CallMeC/RP2040_FT8_TRX/README.md

# RP2040_FT8_TRX
Yet another RP2040 project, but this time radio ham

# Features :
- USB Serial communication
- Class-E Amplifier (25W target)
- Accurate clock generator (Si5351)

Capture d'écran 2025-04-05 213534
Capture d'écran 2025-04-05 213553
Capture d'écran 2025-04-05 213559
