CallMeC/RP2040_FT8_TRX/HW/FT8_RP2040_TRX/Project Outputs/Fabrication/BOM/FT8.xlsx

Designator | Comment | Description | Footprint | Quantity | LCSC_Part_# | LCSC_Price_1ku | MFR_Part_# | MFR
BT1 | BAT-HLD-001 | CR2032 Phosphor Bronze / Nickel Plated 20 mm Cell Size Battery Holder | BATHLD-001 | 1 | C7501066 | 0.4659 | BAT-HLD-001 | TE Connectivity
C1, C3, C18, C26, C28, C30, C32, C41 | 10u X5R 35V 10% 0603 | MLCC 10u X5R 35V 10% 0603 | C0603 | 8 | C194427 | 0.0213 | GRM188R6YA106MA73D
C2, C4, C5, C6, C21, C27, C29, C31, C33, C42, C48, C49, C50, C51, C52, C53, C54, C56, C58, C59, C60, C67 | 100 nF 10% 50 V 0603 | Chip Capacitor, 100 nF, +/- 10%, 50 V, 0603 (1608 Metric) | CAPC1608X90X40NL10T20 | 22 | C14663 | 0.0015 | CC0603KRX7R9BB104
C7, C11 | 2.2nF 10% X7R 50V | Chip Capacitor, 2.2nF, 10%, 50 V, 0603 | CAPC1608X90X40NL10T20 | 2 | C107082 | 0.0021 | CC0603KRX7R9BB222
C8, C14, C16 | RVT2A100M0810 | Cap Aluminum 10uF 100V 20% (8 X 10.2mm) SMD 85mA 2000 hr 85°C T/R | FP-SF-MFG | 3 | C2895755 | 0.0415 | RVT2A100M0810 | Honor Elec
C9, C15 | 100 nF 10% 100V | Chip Capacitor, 100 nF, +/- 10%, 100 V, 0603 (1608 Metric) | CAPC1608X90X40NL10T20 | 2 | C15725 | 0.0066 | CL10B104KC8NNNC | Samsung
C10, C17 | 1uF X7R 10% 100 V 0805 | Chip Capacitor, 1 uF, X7R 10%, 100 V, 0805 | CAPC2013X95X50NL10T25 | 2 | C22367837 | 0.0246 | HHV0805R7105K101NSLJ
C12 | 22u X7R 25V 10% 1210 | MLCC 22u X7R 25V 10% 1210 | C1210 | 1 | C309062 | 0.0679 | CL32B226KAJNNNE
C13 | 68p 10% 50V | Chip Capacitor, 68pF, +/- 10%, 50 V, 0603 (1608 Metric) | CAPC1608X90X40NL10T20 | 1 | C62782 | 0.0019 | CC0603JRNPO9BN680
C19, C24 | FKP2O111001I00HC00 | Condensateurs à film FKP 2 1000 pF 1000 VDC 6.5x8x7.2 PCM 5 | FKP2O111001I00HC00-Footprint-1 | 2 |  |  | FKP2O111001I00HC00
C20 | FKP2D002201D00HA00 | Condensateurs à film 220 pF 100 VDC 2.5% | FKP2O111001I00HC00-Footprint-1 | 1 |  |  | FKP2O111001I00HC00
C22 | FKP2F004701D00HA00 | Condensateurs à film 470 pF 250 VDC 2.5% | FKP2O111001I00HC00-Footprint-1 | 1 |  |  | FKP2F004701D00HA00
C23 | FKP2D012201D00HC00 | Condensateurs à film 2200pF 100 Volt 2.5% | FKP2O111001I00HC00-Footprint-1 | 1 |  |  | FKP2D012201D00HC00
C34 | 470nF 20% 25V 0603 | Chip Capacitor, 470nF +/-20%, 25V, 0603, Thickness 1 mm | CAPC0603(1608)100_L | 1
C35, C37, C47, C55, C57, C62, C66, C69 | 4.7uF 10% 16 V 0603 | Chip Capacitor, 4.7uF, +/- 10%, 16V, 0603 (1608 Metric) | CAPC1608X90X40NL10T20 | 8 | C19666 | 0.0063 | CL10A475KO8NNNC
C36, C68 | 1nF 10% 50 V 0603 | Chip Capacitor, 1 nF, 10%, 50 V, 0603 (1608 Metric) | CAPC1608X90X40NL10T20 | 2 | C1588 | 0.0020 | CL10B102KB8NNNC
C38 | 22n X7R 100V 10% 0603 | MLCC 22n X7R 100V 10% 0603 | C0603 | 1 | C313105 | 0.0071 | CC0603KRX7R0BB223
C39, C40 | 22pF 10% 16V 0603 | Chip Capacitor, 22pF, 10%, 16V, 0603 (1608 Metric) | CAPC1608X90X40NL10T20 | 2 | C561800 | 0.0209 | C0603C220J4GAC7867
C43, C44, C70, C71, C72 | 10 nF 10% 50 V 0603 | Chip Capacitor, 10 nF, +/- 10%, 50 V, 0603 (1608 Metric) | CAPC1608X90X40NL10T20 | 5 | C57112 | 0.0015 | 0603B103K500NT
C45 | 20 pF 5% 16V | Chip Capacitor, 20 pF, +/- 5%, 16V, 0603 (1608 Metric) | CAPC1608X90X40NL10T20 | 1 | C2190570 | 0.0022 | CC0603JRNPO7BN200
C46 | 20 pF +/- 5% 16 V 0603 | Chip Capacitor, 20 pF, +/- 5%, 16V, 0603 (1608 Metric) | CAPC1608X90X40NL10T20 | 1 | C2190570 | 0.0022 | CC0603JRNPO7BN200
C61, C63, C64, C65 | 2.2nF 10% X7R 50V 0603 | Chip Capacitor, 2.2nF, 10%, 50 V, 0603 | CAPC1608X90X40NL10T20 | 4 | C107082 | 0.0021 | CC0603KRX7R9BB222
CN1 | DX07S024JJ3R1300 | USB-C Connector, 20 V, 1.25 A, -30 to 80 degC, RoHS, Tape and Reel | JAE-DX07S024JJ3_V | 1
D1, D2, D3, D4, D5, D7 | KT-0603G | 0603 Green LED | LED-0603-RED | 6 | C12624 | 0.0068 | KT-0603G
D6 | SS210 | Schottky Diode, 2A, 100V, Smb | DO214AC(SMA) | 1 | C14996 | 0.0124 | SS210
J1 | 2.54-1*4P | 2.54mm Single Row 3A 4P Bronze -40℃~+105℃ Direct Insert 1x4P Top Square Hole Plugin,P=2.54mm Female Headers ROHS | FP-87224-3-MFG | 1 | C2718488 | 0.026 | 2.54-1*4P | BOOMELE(Boom Precision Elec)
J3 | MX635-6.35-02P-GN01-Cu-PS-A | Copper Alloy 1x2P Tin 6.35mm 4 1 2 -40℃~+105℃ 30A 300V Green 10~26 Straight Plugin,P=6.35mm Screw terminal ROHS | MX635-6.35-02P-GN01-Cu-PS-A-Footprint-1 | 1 | C5188489 | 0.1045 | MX635-6.35-02P-GN01-Cu-PS-A
J4, J6 | BWSMA-KE-P001 | 1 Inner Hole SMA Board-End Staggered pins 50Ω 5.2mm SMD Coaxial Connectors (RF) ROHS | TE_CONSMA020.062-G | 2 | C496550 |  | BWSMA-KE-P001 | BAT WIRELESS
J5 | SJ1-3523N | 3.5 mm, Stereo, Right Angle, Through Hole, 3 Conductors, 0 Internal Switches, Audio Jack Connector | CUI_SJ1-3523N | 1 | C20182914 | 0.6476 | SJ1-3523N | CUI
K1 | SRD-05VDC-SL-C | 5V Trigger Relay Module For Arduino And Raspberry Pi 5V Trigger Relay Module For Arduino And Raspberry Pi | RELAY_SRD-05VDC-SL-C | 1 | C35449 | 0.18 | SRD-05VDC-SL-C
L1 | SMDRI127-680MT | 2.1A 68uH Shielded inductor ±20% 4A SMD,12.3x12.3mm Power Inductors ROHS | SUMI-CDRH127_V | 1 | C9907 | 0.0993 | SMDRI127-680MT
L2 | FXL0630-100-M | 4.5A 10uH Molding Choke ±20% 5.5A SMD,6.6x7mm Power Inductors ROHS | INDP7066X30N | 1 | C167223 | 0.0934 | FXL0630-100-M
L3 | SRR5228A-100M | Inductances de puissance - CMS Ind,5.2x5.2x2.8,10uH+/-20%,2.3A,shd | INDP5252X32N | 1 |  |  | SRR5228A-100M | Bourns
L4 | LQH55DNR12M03L | Inductor Power Chip Unshielded Wirewound 120nH 20% 1MHz Ferrite 6A 9.8mOhm DCR 2220 T/R | FP-LQH55DN_03-MFG | 1 | C711154 | 0.2902 | LQH55DNR12M03L | Murata
L5 | 7449150146 | Inductor, 146Nh, 332Mhz, 19A, 20% Rohs Compliant: Yes | 7449150146 | 1 |  |  | 7449150146 | Wurth Elektronik
Q1 | CSD19538Q2 | 100-V, N channel NexFET™ power MOSFET, single SON 2 mm x 2 mm, 59 mOhm 6-WSON -55 to 150 | FP-DQK0006C-MFG | 1 | C2838636 | 0.3656 | CSD19538Q2
Q2 | 2N7002K | Mosfet N-ch 60V 300MA SOT23 / Trans Mosfet N-ch 60V 0.3A 3-PIN SOT-23 T/r | FP-318-08-IPC_B | 1 | C5247922 | 0.00119 | 2N7002K
R1, R8, R10, R15, R16, R18, R20 | 1K 1% 0.1W | Standard Resistor 1K 1% 0.1W 0603 | R0603 | 7 | C21190 | 0.0007 | 0603WAF1001T5E
R2 | 10K 1% 0.1W | Standard Resistor 10K 1% 0.1W 0603 | R0603 | 1 | C25804 | 0.0007 | 0603WAF1002T5E
R3, R5 | 681K 1% 0.1W | Standard Resistor 681K 1% 0.1W 0603 | R0603 | 2 | C23229 | 0.0007 | 0603WAF6813T5E
R4 | 0R 1% 0.1W | Standard Resistor 0R 1% 0.1W 0603 | R0603 | 1 | C21189 | 0.0006 | 0603WAF0000T5E
R6 | 100K 1% 0.1W | Standard Resistor 100K 1% 0.1W 0603 | R0603 | 1 | C25803 | 0.0007 | 0603WAF1003T5E
R7 | 215K 1% 0.1W 0603 | Standard Resistor 215K 1% 0.1W 0603 | R0603 | 1 | C5713280 | 0.0007 | FRC0603F2153TS
R9 | 10R 1% 0.1W 0603 | Standard Resistor 10R 1% 0.1W 0603 | R0603 | 1 | C22859 | 0.0007 | 0603WAF100JT5E
R11, R22 | 27R 1% 0.1W 0603 | Standard Resistor 27R 1% 0.1W 0603 | R0603 | 2 | C25224 | 0.0007 | 0603WAJ0270T5E
R12, R13, R23, R26, R29, R30, R31, R32, R33 | 10K 1% 0.1W 0603 | Standard Resistor 10K 1% 0.1W 0603 | R0603 | 9 | C25804 | 0.0007 | 0603WAF1002T5E
R14, R21 | 5.1K 1% 0.1W 0603 | Standard Resistor 5.1K 1% 0.1W 0603 | R0603 | 2 | C23186 | 0.0007 | 0603WAF5101T5E
R17 | 2K 1% 0.1W 0603 | Standard Resistor 2K 1% 0.1W 0603 | R0603 | 1 | C22975 | 0.0007 | 0603WAF2001T5E
R19 | 100R 1% 0.1W 0603 | Standard Resistor 100R 1% 0.1W 0603 | R0603 | 1 | C22775 | 0.0008 | 0603WAF1000T5E
R24, R25 | 0R 1% 1206 250 mW | Chip Resistor, 0 Ohm, 0.25 W, -55 to 155 degC, 1206 (3216 Metric) | RESC3116X70X50ML13T20 | 2
SW1, SW2, SW3, SW4, SW5 | SKRPASE010 | Tactile Switches 500mOhm 2.55N 16VDC 4.2X3.2X2.5MM 50mA | SKRPASE010 | 5 | C470427 | 0.0694 | SKRPASE010
U1, U6, U7 | AP2127K-3.3TRG1 | IC REG LDO 3.3V 0.3A SOT23-5 | FP-SOT25-IPC_B | 3 | C156285 | 0.0388 | AP2127K-3.3TRG1 | Diodes Incorporated
U2 | SI5351A-B-GTR | IC CLK GENERATOR 160MHZ 10MSOP | FP-SI5351A-B-GTR-IPC_B | 1 | C504891 | 0.5946 | SKYWORKS/SILICON LABS | SI5351A-B-GTR
U3 | DS1302Z | Three-Wire Serial Interface SOP-8 Real Time Clocks ROHS | SO8 | 1 | C2900599 | 0.1005 | DS1302Z | JSMSEMI
U4 | LM5164DDAR | 6-V to 100-V input, 1-A synchronous buck DC-DC converter with ultra-low IQ 8-SO PowerPAD -40 to 150 | FP-DDA0008E-IPC_B | 1 | C477928 | 0.3281 | LM5164DDAR
U5 | UCC27519DBVT | 4-A/4-A single-channel gate driver with 5-V UVLO, enable, and CMOS input 5-SOT-23 -40 to 140 | FP-DBV0005A-IPC_B | 1 | C2676969 | 0.5183 | UCC27519DBVT | Texas Instruments
U8 | SI4735-D60-GU | RF Receiver AM/FM/LW/SW 3.3V/5V Automotive 24-Pin SSOP Tube | SLAB-SSOP-24_N | 1 | C1526089 | 8.7411 | SI4735-D60-GU | SKYWORKS/SILICON LABS
U9 | RP2040 | 133MHz LQFN-56(7x7) Microcontrollers (MCU/MPU/SOC) ROHS ARM® Cortex®-M0+ MCU 32-Bit | QFN40P700X700X90-57N | 1 | C2040 | 0.6733 | RP2040 | Raspberry Pi
U10 | W25Q16JVUXIQ | 16Mb Serial NOR Flash 133MHz USON8 | FP-UX-IPC_B | 1 | C2843335 | 0.2127 | W25Q16JVUXIQ | Winbond Elec
U11 | SN74LV4052APWR | 2 Circuit IC Switch 4:1 75 Ohm 16-TSSOP | PW0016A_N | 1 | C8142 | 0.0974 | SN74LV4052APWR | Texas Instruments
U12 | MCP6002-I/SN | MCP6002 Series 6 V 1 MHz SMT Low-Power Operational Amplifier - SOIC-8 | SOIC-SN8_N | 1 | C116706 | 0.238 | MCP6002-I/SN | Microchip Tech
Y1 | XG1EL89CKI-111YLC-25M | 25MHz Surface Mount Crystal 8pF ±10ppm ±20ppm SMD5032 Crystals ROHS | X50328MSB2GI-Footprint-1 | 1 | C19711738 | 0.1118 | XG1EL89CKI-111YLC-25M
Y2, Y3 | Q13FC13500049 | 32.768kHz Surface Mount Crystal 6pF ±20ppm SMD3215-2P Crystals ROHS | FP-ABS07-120-MFG | 2 | C95361 | 0.1269 | Q13FC13500049 | Seiko Epson
Y4 | X503212MSB2GI | 12MHz Surface Mount Crystal 20pF ±10ppm ±20ppm SMD5032 Crystals ROHS | X50328MSB2GI-Footprint-1 | 1 | C112573 | 0.1205 | X503212MSB2GI
