CallMeC/RP2040_FT8_TRX/(threads)

Thread 1 (2024-07-28):

how do i get it?

DuckyPolice, 2024-07-28:
how do i get it. its just readme

CallMeC, 2024-07-28:
Hi !
I did'nt upload any schematics / code yet since I've been working on other project. So far I only made the Class-E amp. I'll upload soon :)
Best regards,

DuckyPolice, 2024-07-28:
does/will it run barebones without anything except for an antenna attached to the pico?

CallMeC, 2024-07-29:
Hi !
As this projects deals with high frequencies, I was planning on using an external oscillator to make the signal, it would be connected to an amplifier.
I am not sure if the RP2040 has the correct ressources to achieve a high frequency (with proper harmonics levels) and high power output.
Any suggestion is welcomed !
Best regards :)
