CallMeC/RP2040_FT8_TRX/HW/FT8_RP2040_TRX/Project Outputs/Fabrication/Schematic Prints/FT8.PDF

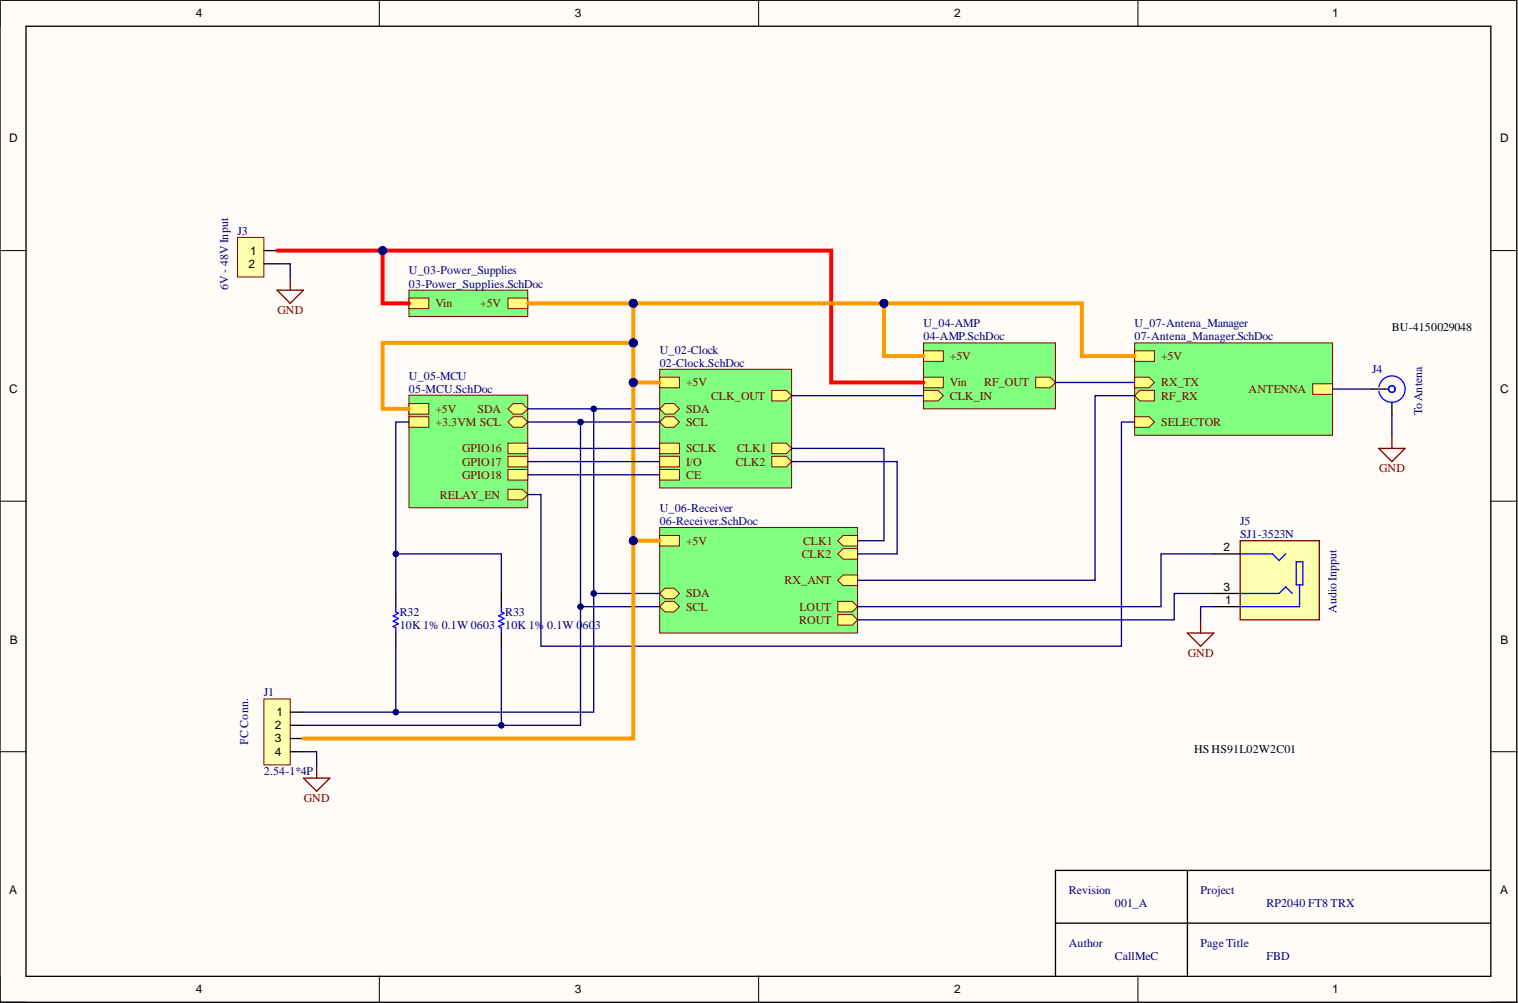
[picture p1: page 1]

i s i o n 0 0 1 _A | Projec t RP2 0 4 0 FT 8 TRX

A u t h o r Cal lMe C | Page T i l e FBD

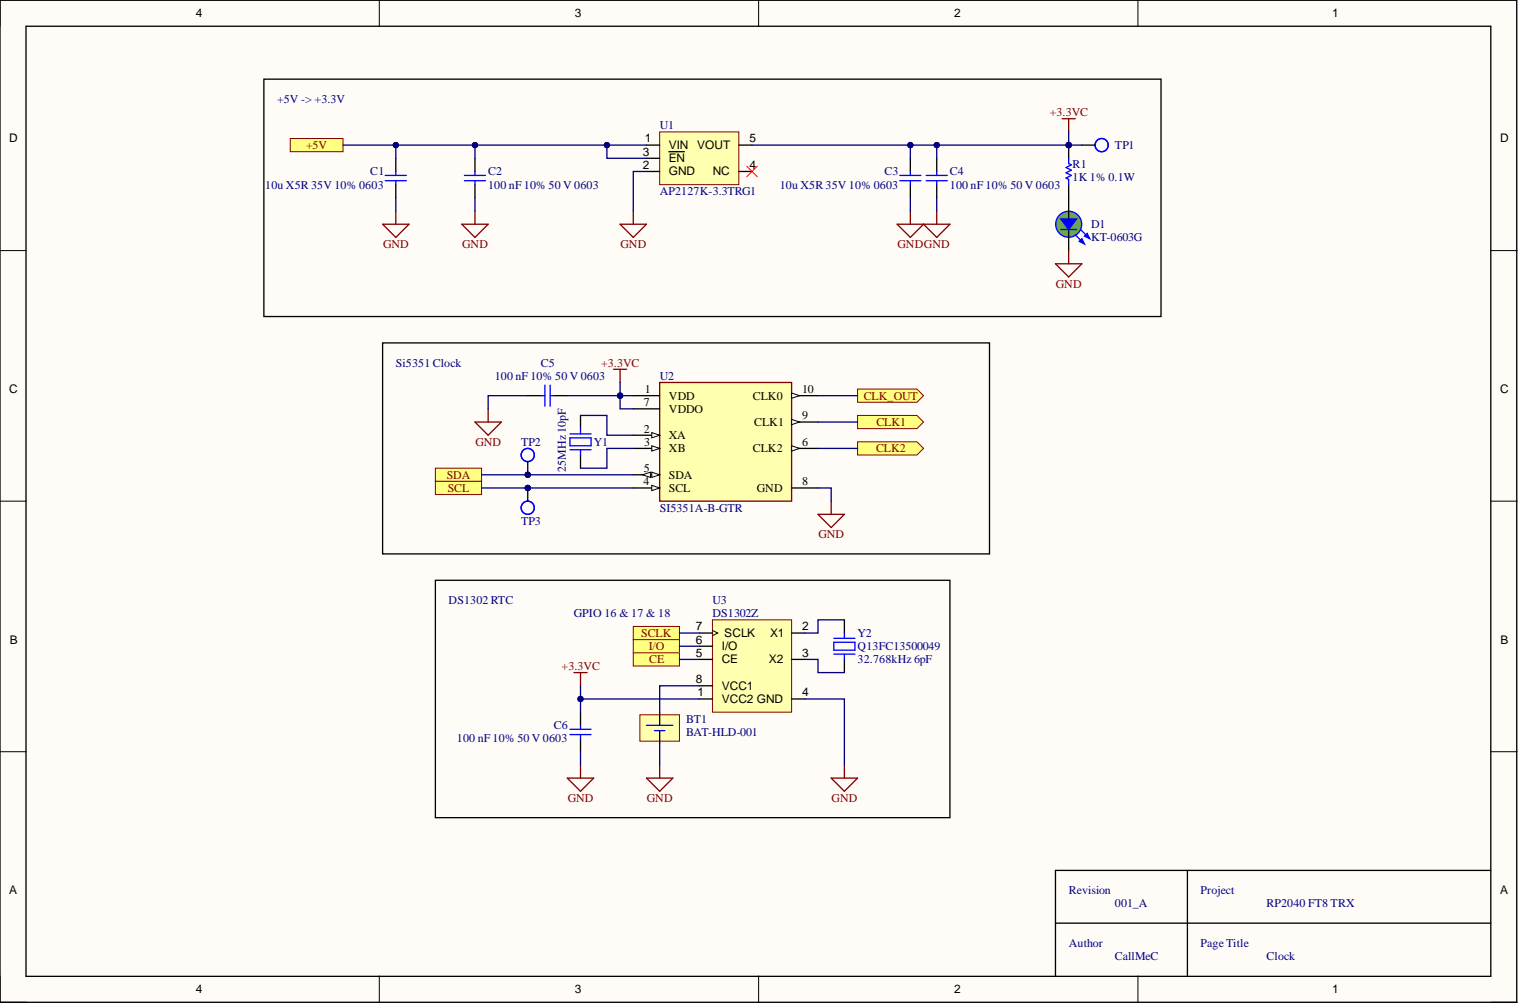
[picture p2: page 2]

001_A | Project RP2040 FT8 TRX

Author CallMeC | Page Title Clock

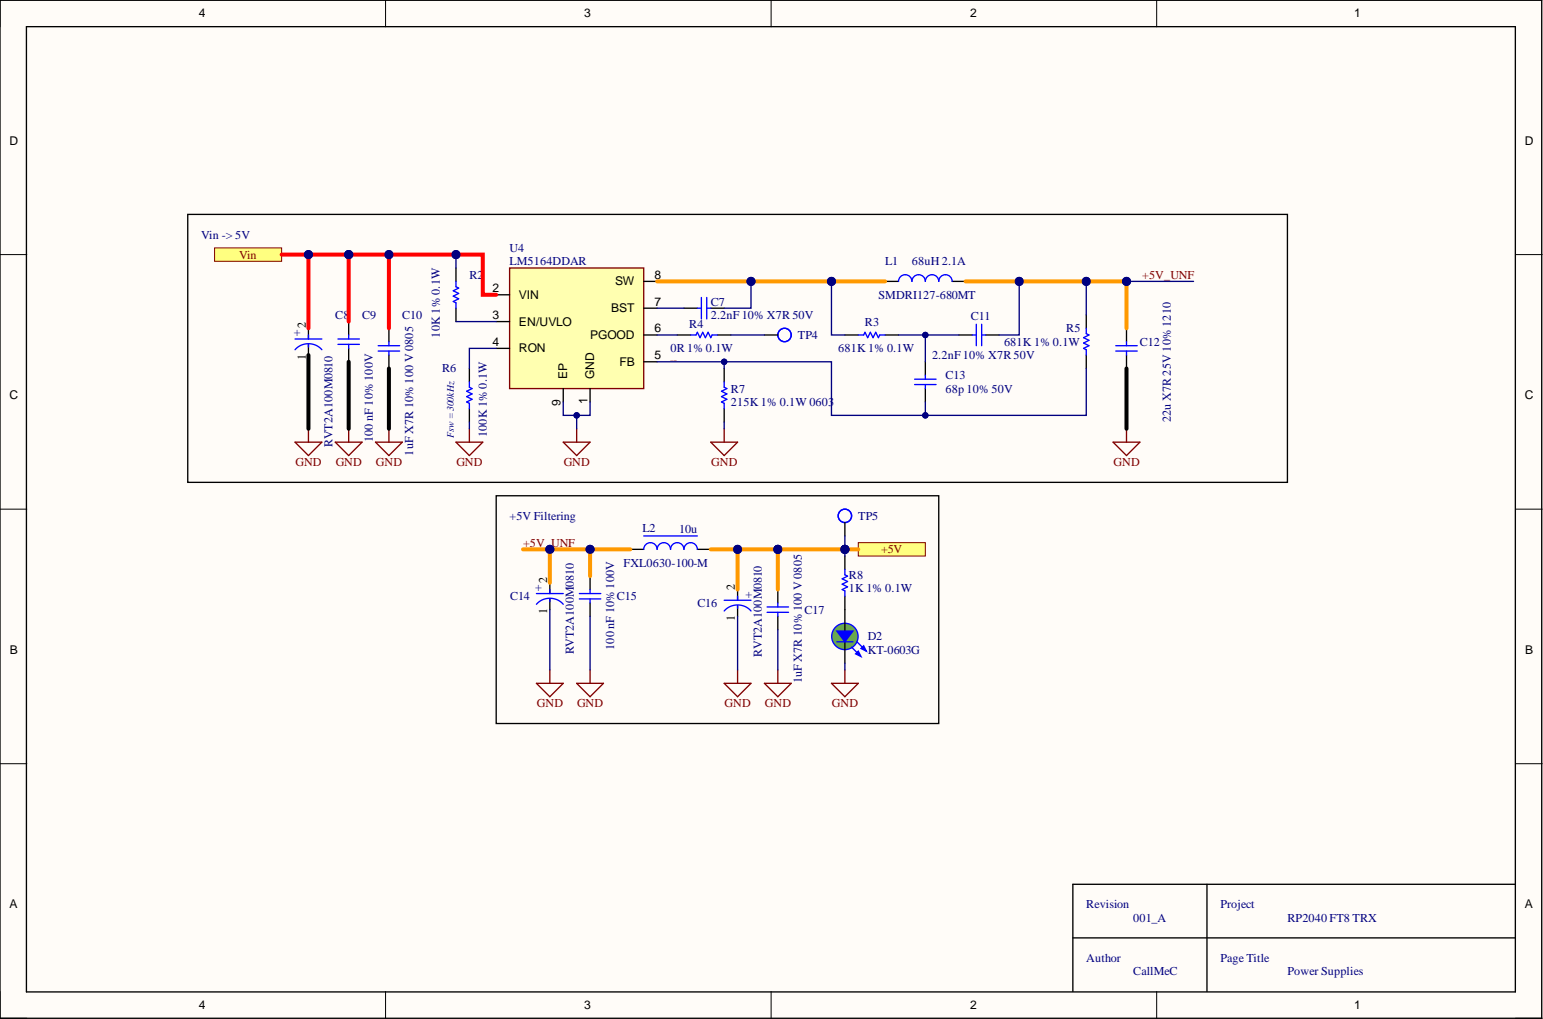
[picture p3: page 3]
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

Po wer Su p p s

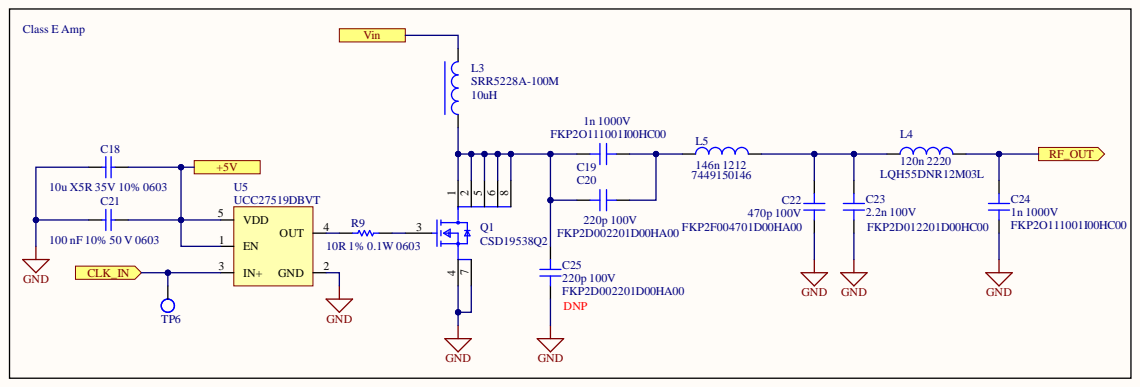
[picture p4: page 4]
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

Amp ifi er

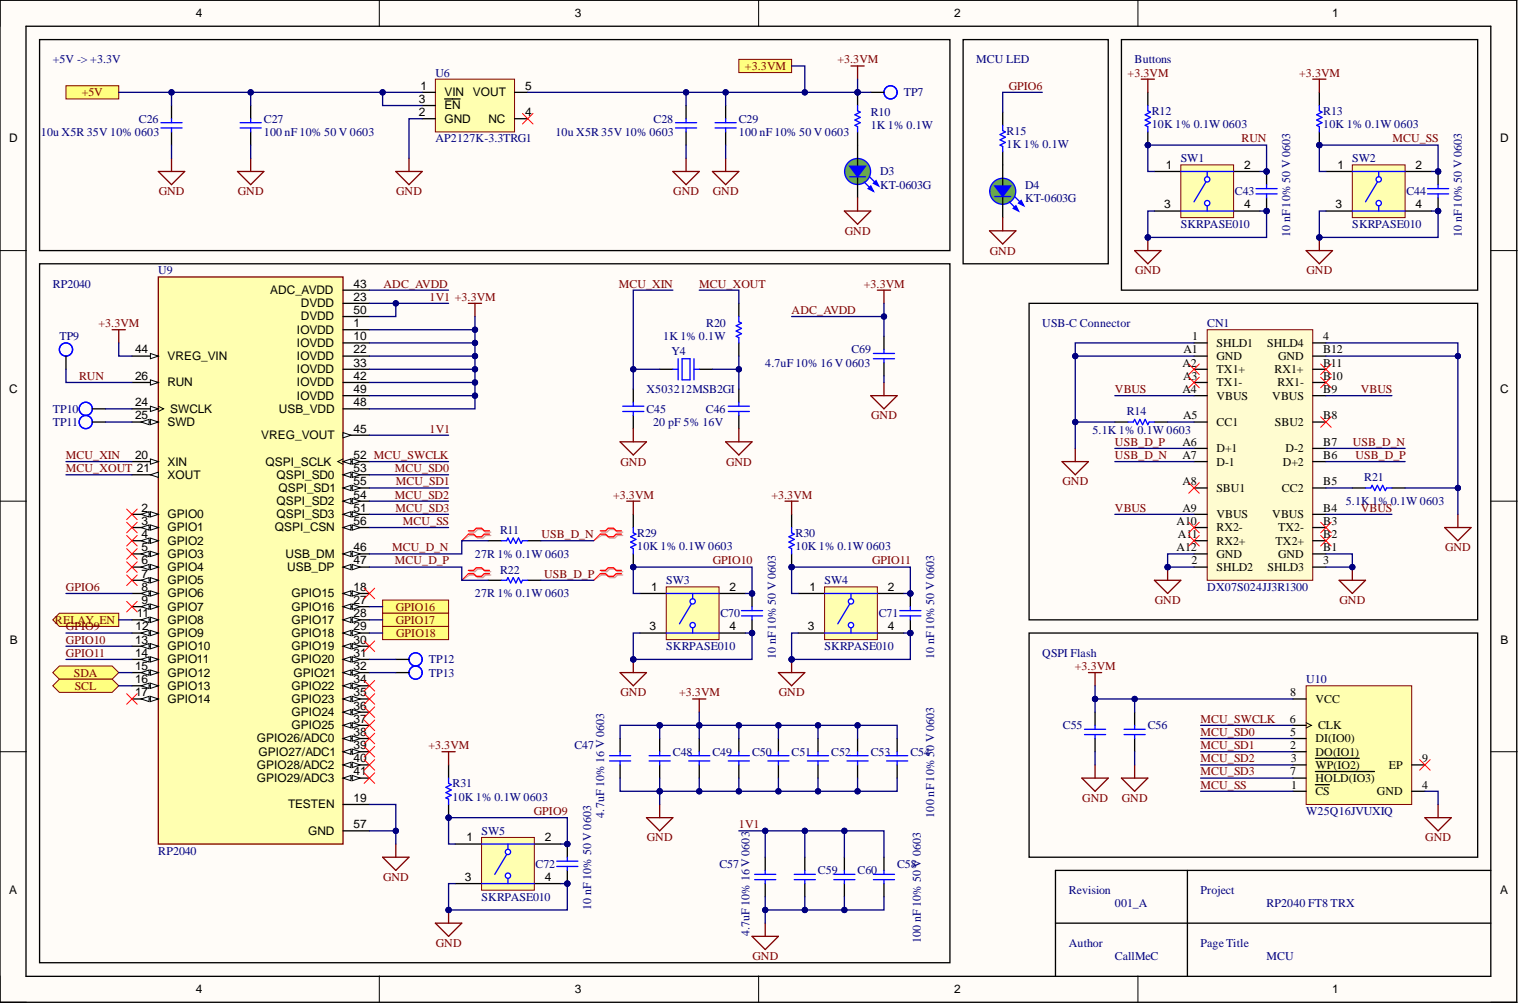
[picture p5: page 5]
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

MCU

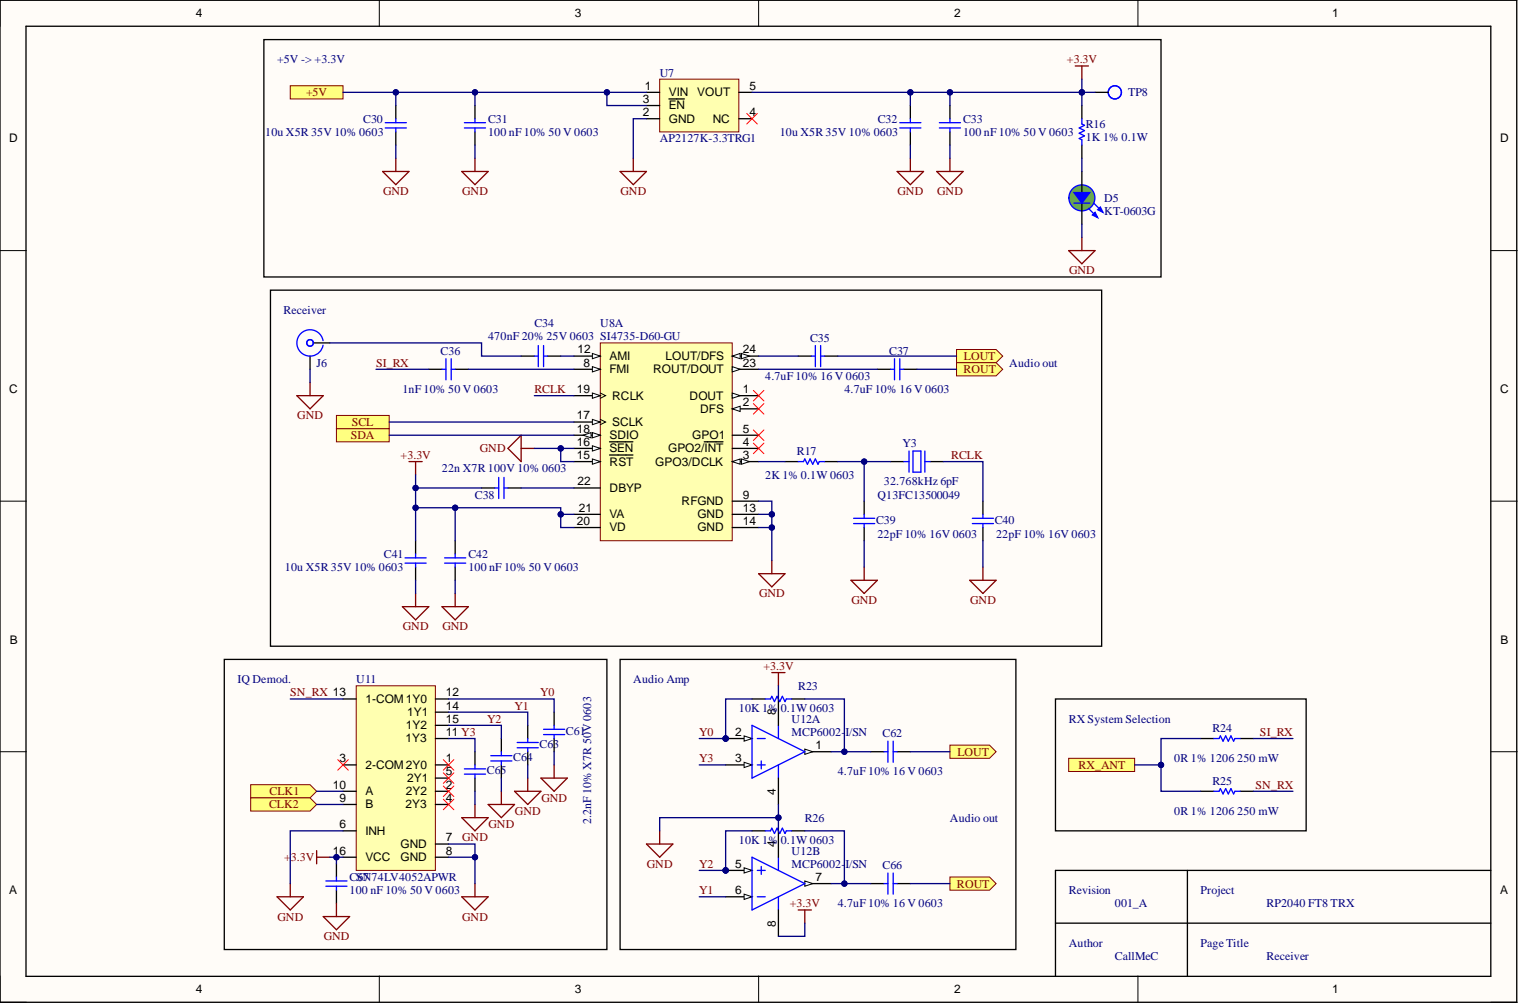
[picture p6: page 6]

VIN 1 | GND
EN 3
GND 2

VCC 16

001_A | Project RP2040 FT8 TRX

Receiver

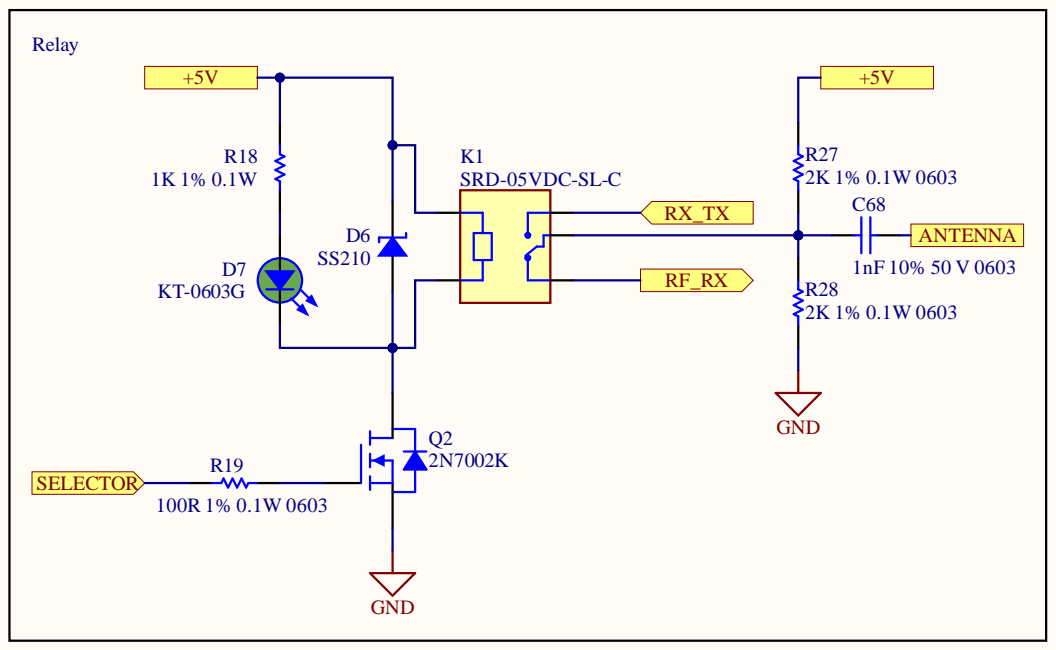
[picture p7: page 7]

001_A | Project RP2040 FT8 TRX

Antena Manager
