CallMeC/RP2040_FT8_TRX/HW/FT8_RP2040_TRX/Project Outputs/Fabrication/Fabrication Drawing/FT8.PDF

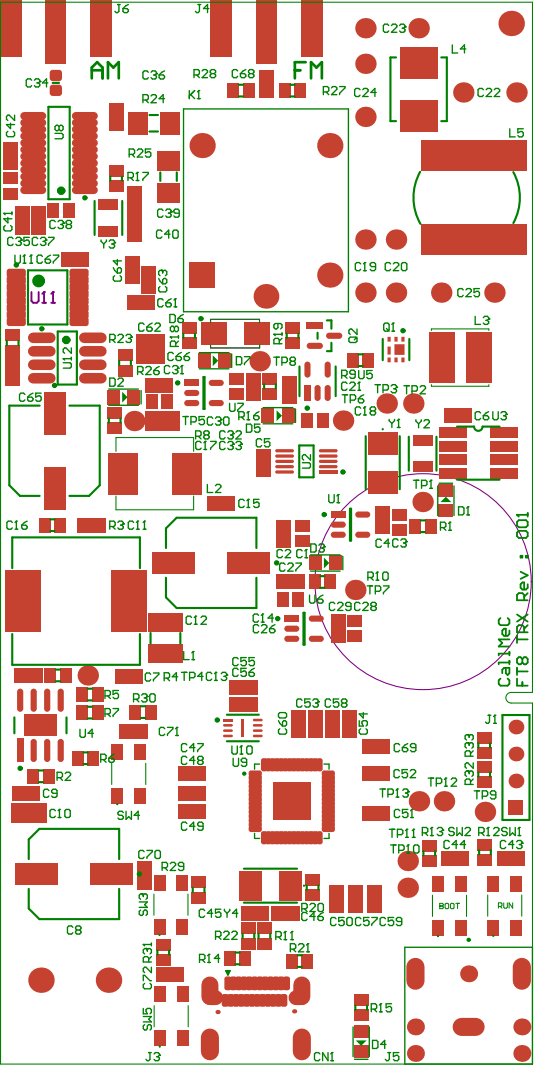
[picture p8: page 1]
