CallMeC/RP2040_FT8_TRX/(list of files, drawings)

Other design files:
HW/FT8_RP2040_TRX/00-History.SchDoc
HW/FT8_RP2040_TRX/01-FBD.SchDoc
HW/FT8_RP2040_TRX/001_FT8_RP2040_TRX.PcbDoc
HW/FT8_RP2040_TRX/02-Clock.SchDoc
HW/FT8_RP2040_TRX/02-MCU.SchDoc
HW/FT8_RP2040_TRX/03-Power_Supplies.SchDoc
HW/FT8_RP2040_TRX/03-Transmitter.SchDoc
HW/FT8_RP2040_TRX/04-AMP.SchDoc
HW/FT8_RP2040_TRX/04-Receiver.SchDoc
HW/FT8_RP2040_TRX/05-MCU.SchDoc
HW/FT8_RP2040_TRX/06-Receiver.SchDoc
HW/FT8_RP2040_TRX/07-Antena_Manager.SchDoc
HW/FT8_RP2040_TRX/FT8.PcbDoc
HW/FT8_RP2040_TRX/FT8.PcbLib
HW/FT8_RP2040_TRX/FT8.PrjPcb
HW/FT8_RP2040_TRX/FT8_RP2040_TRX.PrjPcb
