CallMeC/RP2040_FT8_TRX/SW/RP2040/IO_Definition.h

#ifndef __IO_DEFINITION__H
#define __IO_DEFINITION__H

//Param HW
#define PIN_0                   0
#define PIN_1                   1
#define PIN_2                   2
#define PIN_3                   3
#define PIN_4                   4
#define PIN_5                   5
#define OUTPUT_LED              6
#define PIN_7                   7
#define ANTENNA_RELAY           8
#define USER_SW_5               9
#define USER_SW_3               10
#define USER_SW_4               11
#define I2C_SDA                 12
#define I2C_SCL                 13
#define PIN_14                  14
#define PIN_15                  15
#define RTC_SCLK                16
#define RTC_IO                  17
#define RTC_CE                  18
#define PIN_19                  19
#define PIN_20                  20
#define PIN_21                  21
#define PIN_22                  22
#define PIN_23                  23
#define PIN_24                  24
#define PIN_25                  25
#define PIN_26                  26
#define PIN_27                  27
#define PIN_28                  28
#define PIN_29                  29

#endif
