CallMeC/RP2040_FT8_TRX/(commit log)

2025-03-04 Project creation
    [00-History.SchDoc, 001_FT8_RP2040_TRX.PcbDoc, 01-FBD.SchDoc, 02-MCU.SchDoc, 03-Transceiver.SchDoc, 04-Receiver.SchDoc, FT8_RP2040_TRX.PrjPcb]
2025-03-04 Project files creation
    [00-History.SchDoc, 01-FBD.SchDoc, 03-Transceiver.SchDoc, 03-Transmitter.SchDoc, FT8_RP2040_TRX.PrjPcb]
2025-04-05 First PCB revision
2025-04-08 Added 2 push-buttons
2025-05-18 added USR Button interface
2025-05-21 Cleaned VCO driver
2025-05-30 Fixed VFO driver
